uncovert/CipinkoKlingacik/hardware/manufacturing/drill-report.txt

Drill report for cipinkoklingacik.kicad_pcb
Created on 2026-10-30T13:48:10

Copper Layer Stackup:
    =============================================================
    L1 :  F.Cu                      front
    L2 :  B.Cu                      back

Drill file 'cipinkoklingacik-PTH.drl' contains
    plated through holes:
    =============================================================
    T1  0.300mm  0.0118"  (134 holes))
    T2  1.000mm  0.0394"  (59 holes))

    Total plated holes count 193

Drill file 'cipinkoklingacik-NPTH.drl' contains
    unplated through holes:
    =============================================================
    T1  2.700mm  0.1063"  (4 holes))

    Total unplated holes count 4
