uncovert/CipinkoKlingacik/hardware/cipinkoklingacik-pcb-bottom.png

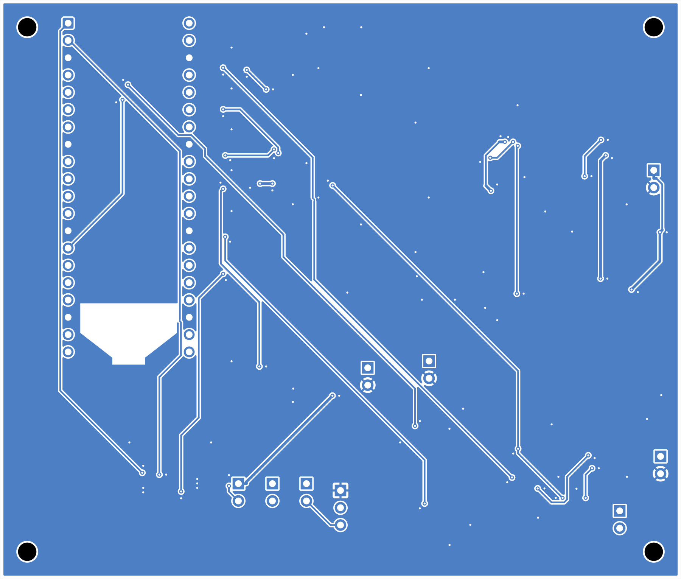
hardware/cipinkoklingacik-pcb-bottom.png
