uncovert/CipinkoKlingacik/hardware/cipinkoklingacik-schematic.png

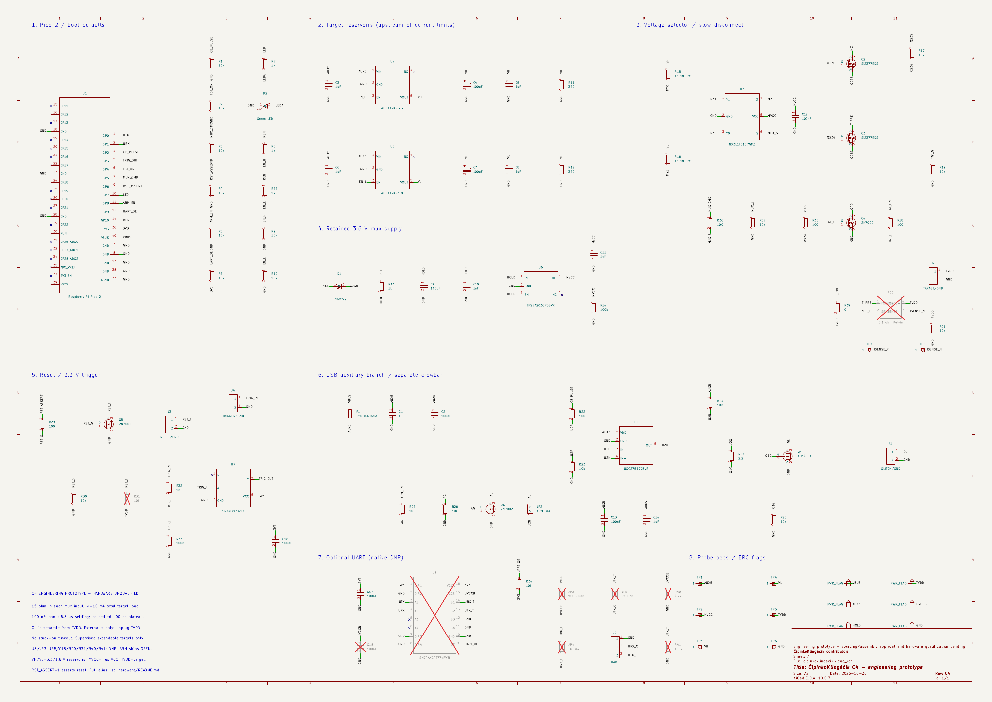
hardware/cipinkoklingacik-schematic.png
