uncovert/CipinkoKlingacik/hardware/visuals/cipinkoklingacik-C4-bottom.png

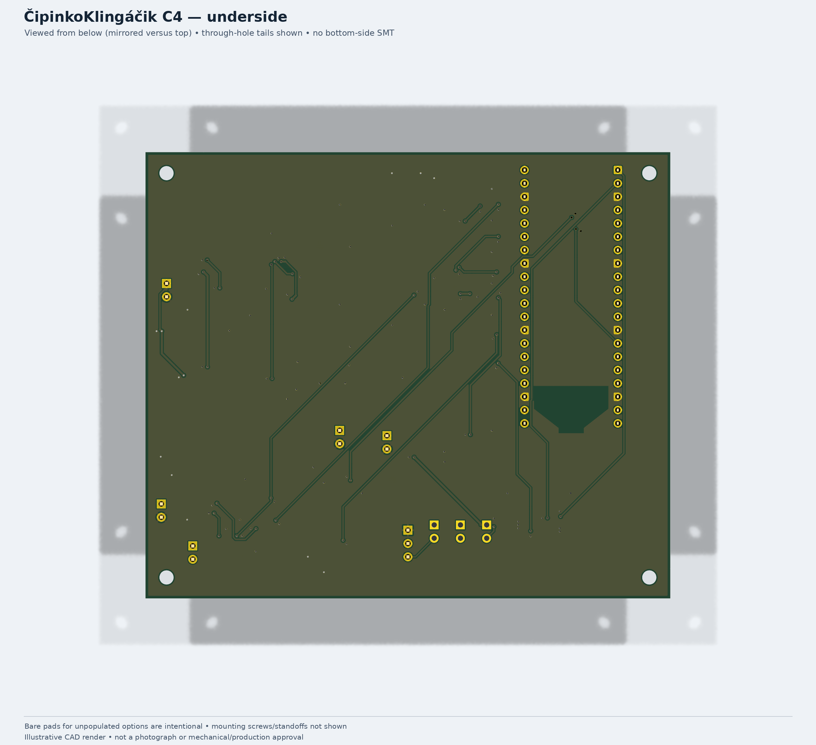
hardware/visuals/cipinkoklingacik-C4-bottom.png
