uncovert/CipinkoKlingacik/hardware/visuals/cipinkoklingacik-C4-module-removed.png

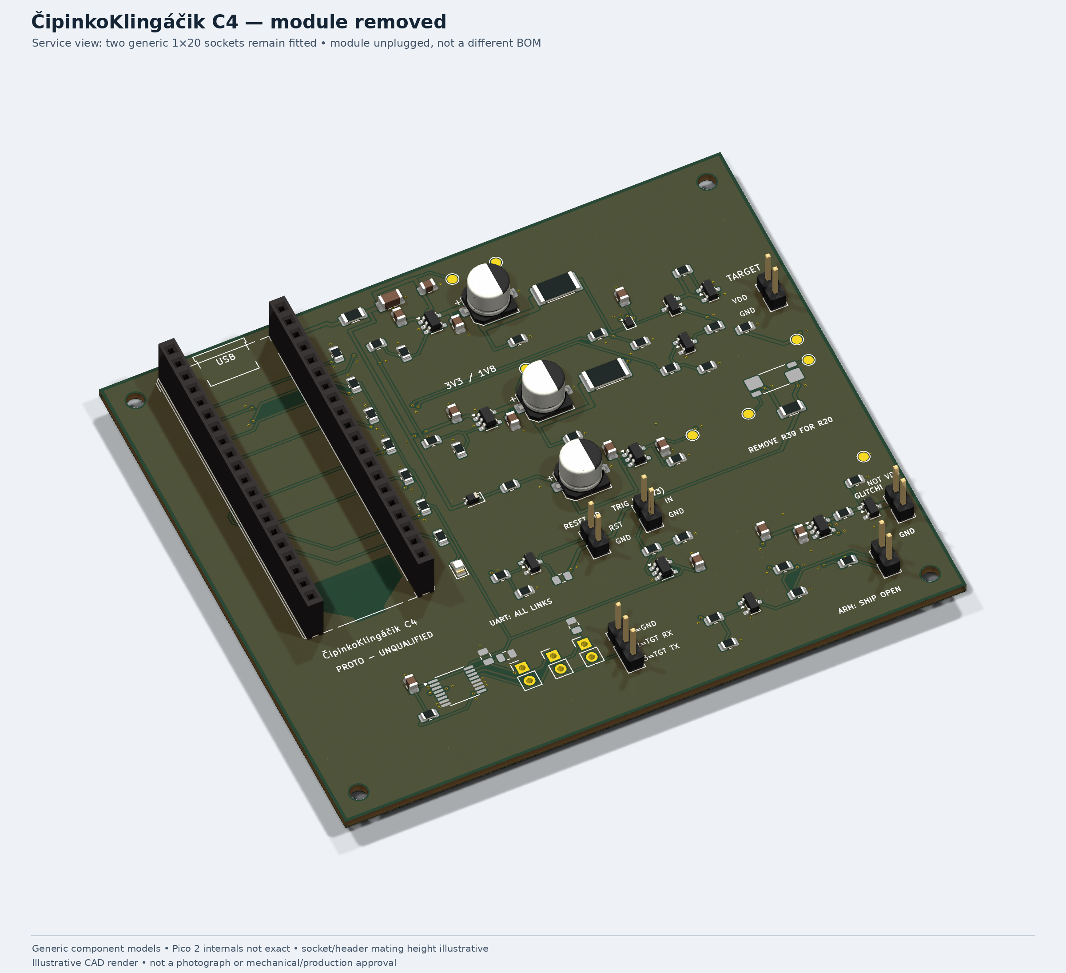
hardware/visuals/cipinkoklingacik-C4-module-removed.png
