uncovert/CipinkoKlingacik/hardware/visuals/cipinkoklingacik-C4-top.png

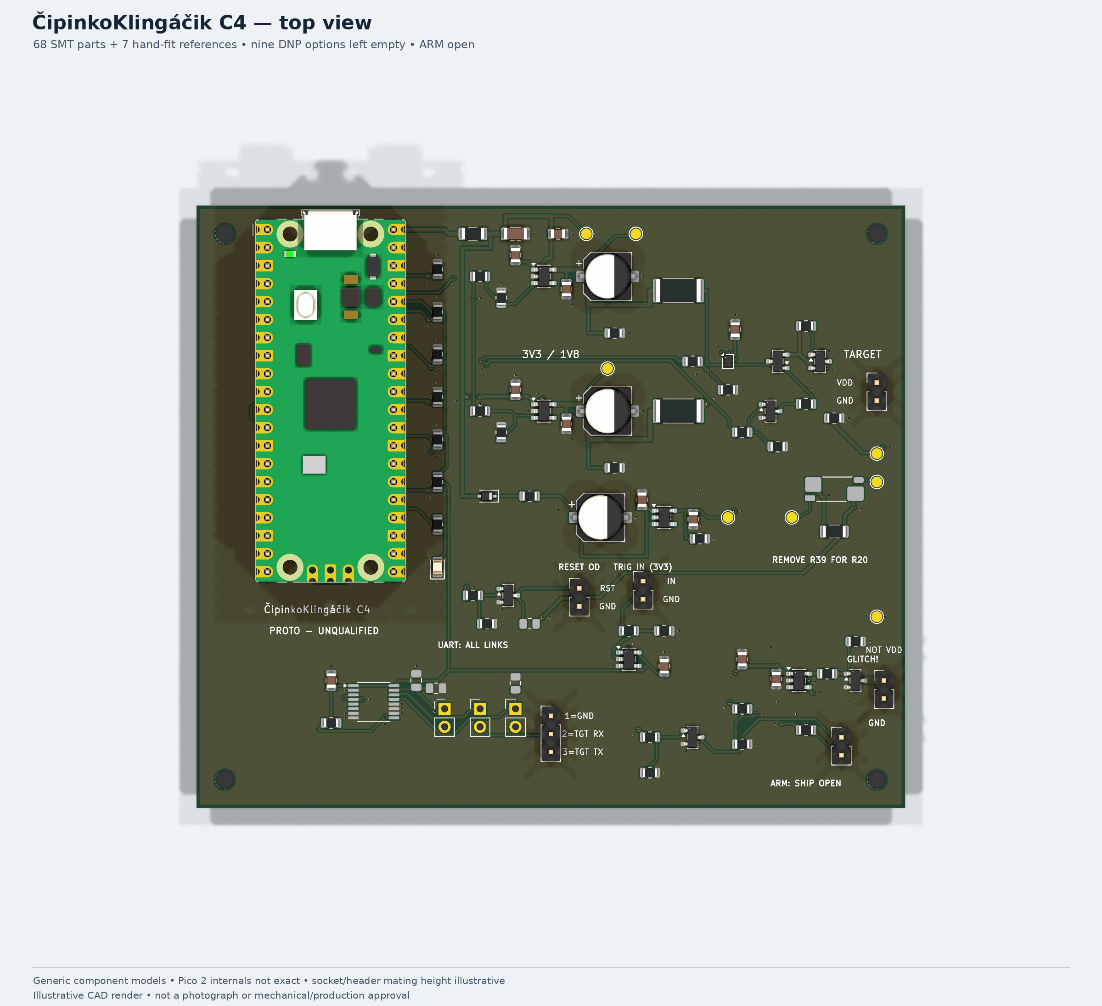
hardware/visuals/cipinkoklingacik-C4-top.png
