uncovert/CipinkoKlingacik/hardware/cipinkoklingacik-bom.csv

Reference | Value | MPN | Manufacturer | Footprint | DNP | Assembly | Requirement | Datasheet | LCSC
U1 | Raspberry Pi Pico 2 | SC1631 | Raspberry Pi | CipinkoKlingacik:RaspberryPi_Pico_Common_THT | no | Module/hand-fit | Pico 2 without headers; hand-fit 2x 1x20 sockets and module headers | https://datasheets.raspberrypi.com/pico/pico-2-datasheet.pdf
R1 | 10k | 0805W8F1002T5E | UNI-ROYAL | CipinkoKlingacik:R_0805_2012Metric | no | SMT | 1%, 0.125 W; gate pulse rating requires check | https://www.lcsc.com/datasheet/lcsc_datasheet_2411221126_UNI-ROYAL-Uniroyal-Elec-0805W8F1002T5E_C17414.pdf | C17414
R2 | 10k | 0805W8F1002T5E | UNI-ROYAL | CipinkoKlingacik:R_0805_2012Metric | no | SMT | 1%, 0.125 W; gate pulse rating requires check | https://www.lcsc.com/datasheet/lcsc_datasheet_2411221126_UNI-ROYAL-Uniroyal-Elec-0805W8F1002T5E_C17414.pdf | C17414
R3 | 10k | 0805W8F1002T5E | UNI-ROYAL | CipinkoKlingacik:R_0805_2012Metric | no | SMT | 1%, 0.125 W; gate pulse rating requires check | https://www.lcsc.com/datasheet/lcsc_datasheet_2411221126_UNI-ROYAL-Uniroyal-Elec-0805W8F1002T5E_C17414.pdf | C17414
R4 | 10k | 0805W8F1002T5E | UNI-ROYAL | CipinkoKlingacik:R_0805_2012Metric | no | SMT | 1%, 0.125 W; gate pulse rating requires check | https://www.lcsc.com/datasheet/lcsc_datasheet_2411221126_UNI-ROYAL-Uniroyal-Elec-0805W8F1002T5E_C17414.pdf | C17414
R5 | 10k | 0805W8F1002T5E | UNI-ROYAL | CipinkoKlingacik:R_0805_2012Metric | no | SMT | 1%, 0.125 W; gate pulse rating requires check | https://www.lcsc.com/datasheet/lcsc_datasheet_2411221126_UNI-ROYAL-Uniroyal-Elec-0805W8F1002T5E_C17414.pdf | C17414
R6 | 10k | 0805W8F1002T5E | UNI-ROYAL | CipinkoKlingacik:R_0805_2012Metric | no | SMT | 1%, 0.125 W; gate pulse rating requires check | https://www.lcsc.com/datasheet/lcsc_datasheet_2411221126_UNI-ROYAL-Uniroyal-Elec-0805W8F1002T5E_C17414.pdf | C17414
R7 | 1k | 0805W8F1001T5E | UNI-ROYAL | CipinkoKlingacik:R_0805_2012Metric | no | SMT | 1%, 0.125 W; gate pulse rating requires check | https://www.lcsc.com/datasheet/lcsc_datasheet_2411221126_UNI-ROYAL-Uniroyal-Elec-0805W8F1002T5E_C17414.pdf | C17513
D2 | Green LED | LTST-C170KGKT | Lite-On | CipinkoKlingacik:LED_0805_2012Metric | no | SMT | Green LED; K1 A2; software status only | https://optoelectronics.liteon.com/upload/download/DS22-2000-223/LTST-C170KGKT.pdf | C98221
R8 | 1k | 0805W8F1001T5E | UNI-ROYAL | CipinkoKlingacik:R_0805_2012Metric | no | SMT | 1%, 0.125 W; gate pulse rating requires check | https://www.lcsc.com/datasheet/lcsc_datasheet_2411221126_UNI-ROYAL-Uniroyal-Elec-0805W8F1002T5E_C17414.pdf | C17513
R9 | 10k | 0805W8F1002T5E | UNI-ROYAL | CipinkoKlingacik:R_0805_2012Metric | no | SMT | 1%, 0.125 W; gate pulse rating requires check | https://www.lcsc.com/datasheet/lcsc_datasheet_2411221126_UNI-ROYAL-Uniroyal-Elec-0805W8F1002T5E_C17414.pdf | C17414
R10 | 10k | 0805W8F1002T5E | UNI-ROYAL | CipinkoKlingacik:R_0805_2012Metric | no | SMT | 1%, 0.125 W; gate pulse rating requires check | https://www.lcsc.com/datasheet/lcsc_datasheet_2411221126_UNI-ROYAL-Uniroyal-Elec-0805W8F1002T5E_C17414.pdf | C17414
R35 | 1k | 0805W8F1001T5E | UNI-ROYAL | CipinkoKlingacik:R_0805_2012Metric | no | SMT | 1%, 0.125 W; gate pulse rating requires check | https://www.lcsc.com/datasheet/lcsc_datasheet_2411221126_UNI-ROYAL-Uniroyal-Elec-0805W8F1002T5E_C17414.pdf | C17513
F1 | 250 mA hold | 1206L025YR | Littelfuse | CipinkoKlingacik:Fuse_1206_3216Metric | no | SMT | 250 mA hold, 500 mA trip, 16 V PTC; 100 A fault rating; R1max 2.3 ohm; 80 ms max trip at 8 A, NOT precision limiting; qualify inrush/drop | https://www.lcsc.com/datasheet/lcsc_datasheet_2304140030_Littelfuse-1206L025YR_C99561.pdf | C99561
C1 | 10uF | GRM31CR71C106KA12L | Murata | CipinkoKlingacik:C_1206_3216Metric | no | SMT | 10 uF, 16 V, X7R, 10%; check DC bias | https://www.murata.com/en-us/products/capacitor/mlcc | C97954
C2 | 100nF | CC0805KRX7R9BB104 | Yageo | CipinkoKlingacik:C_0805_2012Metric | no | SMT | 100 nF, 50 V, X7R, 10% | https://www.lcsc.com/datasheet/lcsc_datasheet_2304140030_YAGEO-CC0805KRX7R9BB104_C49678.pdf | C49678
U2 | UCC27517DBVR | UCC27517DBVR | Texas Instruments | CipinkoKlingacik:SOT-23-5 | no | SMT | 4.90-5.25 V measured at VDD before arm | https://www.ti.com/lit/ds/symlink/ucc27517.pdf | C99395
C13 | 100nF | CC0805KRX7R9BB104 | Yageo | CipinkoKlingacik:C_0805_2012Metric | no | SMT | 100 nF, 50 V, X7R, 10% | https://www.lcsc.com/datasheet/lcsc_datasheet_2304140030_YAGEO-CC0805KRX7R9BB104_C49678.pdf | C49678
C14 | 1uF | GRM21BR71C105KA01L | Murata | CipinkoKlingacik:C_0805_2012Metric | no | SMT | 1 uF, 16 V, X7R, 10%; verify >=0.47 uF at bias | https://www.murata.com/en-us/products/capacitor/mlcc | C77079
R22 | 100 | 0805W8F1000T5E | UNI-ROYAL | CipinkoKlingacik:R_0805_2012Metric | no | SMT | 1%, 0.125 W; gate pulse rating requires check | https://www.lcsc.com/datasheet/lcsc_datasheet_2411221126_UNI-ROYAL-Uniroyal-Elec-0805W8F1002T5E_C17414.pdf | C17408
R23 | 10k | 0805W8F1002T5E | UNI-ROYAL | CipinkoKlingacik:R_0805_2012Metric | no | SMT | 1%, 0.125 W; gate pulse rating requires check | https://www.lcsc.com/datasheet/lcsc_datasheet_2411221126_UNI-ROYAL-Uniroyal-Elec-0805W8F1002T5E_C17414.pdf | C17414
R24 | 10k | 0805W8F1002T5E | UNI-ROYAL | CipinkoKlingacik:R_0805_2012Metric | no | SMT | 1%, 0.125 W; gate pulse rating requires check | https://www.lcsc.com/datasheet/lcsc_datasheet_2411221126_UNI-ROYAL-Uniroyal-Elec-0805W8F1002T5E_C17414.pdf | C17414
Q6 | 2N7002 | 2N7002,215 | Nexperia | CipinkoKlingacik:SOT-23 | no | SMT | G1 S2 D3 | https://assets.nexperia.com/documents/data-sheet/2N7002.pdf | C65189
R25 | 100 | 0805W8F1000T5E | UNI-ROYAL | CipinkoKlingacik:R_0805_2012Metric | no | SMT | 1%, 0.125 W; gate pulse rating requires check | https://www.lcsc.com/datasheet/lcsc_datasheet_2411221126_UNI-ROYAL-Uniroyal-Elec-0805W8F1002T5E_C17414.pdf | C17408
R26 | 10k | 0805W8F1002T5E | UNI-ROYAL | CipinkoKlingacik:R_0805_2012Metric | no | SMT | 1%, 0.125 W; gate pulse rating requires check | https://www.lcsc.com/datasheet/lcsc_datasheet_2411221126_UNI-ROYAL-Uniroyal-Elec-0805W8F1002T5E_C17414.pdf | C17414
JP2 | ARM link | TSW-102-07-G-S | Samtec | CipinkoKlingacik:PinHeader_1x02_P2.54mm_Vertical | no | THT/hand-fit | 2.54 mm header; pin1 marked; hand-fit; removable shunts separate | https://suddendocs.samtec.com/catalog_english/tsw.pdf
Q1 | AO3400A | AO3400A | Alpha & Omega Semiconductor | CipinkoKlingacik:SOT-23 | no | SMT | G1 S2 D3; pulse/thermal qualification required | https://aosmd.com/sites/default/files/res/datasheets/AO3400A.pdf | C20917
R27 | 2.2 | 0805W8F220KT5E | UNI-ROYAL | CipinkoKlingacik:R_0805_2012Metric | no | SMT | 1%, 0.125 W; gate pulse rating requires check | https://www.lcsc.com/datasheet/lcsc_datasheet_2411221126_UNI-ROYAL-Uniroyal-Elec-0805W8F1002T5E_C17414.pdf | C17521
R28 | 10k | 0805W8F1002T5E | UNI-ROYAL | CipinkoKlingacik:R_0805_2012Metric | no | SMT | 1%, 0.125 W; gate pulse rating requires check | https://www.lcsc.com/datasheet/lcsc_datasheet_2411221126_UNI-ROYAL-Uniroyal-Elec-0805W8F1002T5E_C17414.pdf | C17414
J1 | GLITCH/GND | TSW-102-07-G-S | Samtec | CipinkoKlingacik:PinHeader_1x02_P2.54mm_Vertical | no | THT/hand-fit | 2.54 mm header; pin1 marked; hand-fit; removable shunts separate | https://suddendocs.samtec.com/catalog_english/tsw.pdf
D1 | Schottky | BAT54WS-7-F | Diodes Incorporated | CipinkoKlingacik:D_SOD-323 | no | SMT | K1 A2; low-current hold-up charging diode | https://www.diodes.com/assets/Datasheets/BAT54WS.pdf | C124205
R13 | 1k | 0805W8F1001T5E | UNI-ROYAL | CipinkoKlingacik:R_0805_2012Metric | no | SMT | 1%, 0.125 W; gate pulse rating requires check | https://www.lcsc.com/datasheet/lcsc_datasheet_2411221126_UNI-ROYAL-Uniroyal-Elec-0805W8F1002T5E_C17414.pdf | C17513
C9 | 100uF | EEE-FK1C101P | Panasonic | CipinkoKlingacik:CP_Elec_6.3x5.8 | no | SMT | 100 uF 16 V +/-20%, positive pad1; leakage max16 uA; reservoir/hold-up qualification | https://industrial.panasonic.com/cdbs/www-data/pdf/RDE0000/ABA0000C1181.pdf | C128532
C10 | 1uF | GRM21BR71C105KA01L | Murata | CipinkoKlingacik:C_0805_2012Metric | no | SMT | 1 uF, 16 V, X7R, 10%; verify >=0.47 uF at bias | https://www.murata.com/en-us/products/capacitor/mlcc | C77079
U6 | TPS7A2036PDBVR | TPS7A2036PDBVR | Texas Instruments | CipinkoKlingacik:SOT-23-5 | no | SMT | 3.6 V; IN1 GND2 EN3 NC4 OUT5; EN tied to HOLD_IN, not Pico/AUX5; >=0.47 uF effective output; qualify retention/shutdown | https://www.ti.com/lit/ds/symlink/tps7a20.pdf | C2873626
C11 | 1uF | GRM21BR71C105KA01L | Murata | CipinkoKlingacik:C_0805_2012Metric | no | SMT | 1 uF, 16 V, X7R, 10%; verify >=0.47 uF at bias | https://www.murata.com/en-us/products/capacitor/mlcc | C77079
R14 | 100k | 0805W8F1003T5E | UNI-ROYAL | CipinkoKlingacik:R_0805_2012Metric | no | SMT | 1%, 0.125 W; gate pulse rating requires check | https://www.lcsc.com/datasheet/lcsc_datasheet_2411221126_UNI-ROYAL-Uniroyal-Elec-0805W8F1002T5E_C17414.pdf | C149504
U4 | AP2112K-3.3 | AP2112K-3.3TRG1 | Diodes Incorporated | CipinkoKlingacik:SOT-23-5 | no | SMT | 3.3 V; verify reservoir startup and stability | https://www.diodes.com/assets/Datasheets/AP2112.pdf | C51118
C3 | 1uF | GRM21BR71C105KA01L | Murata | CipinkoKlingacik:C_0805_2012Metric | no | SMT | 1 uF, 16 V, X7R, 10%; verify >=0.47 uF at bias | https://www.murata.com/en-us/products/capacitor/mlcc | C77079
C4 | 100uF | EEE-FK1C101P | Panasonic | CipinkoKlingacik:CP_Elec_6.3x5.8 | no | SMT | 100 uF 16 V +/-20%, positive pad1; leakage max16 uA; reservoir/hold-up qualification | https://industrial.panasonic.com/cdbs/www-data/pdf/RDE0000/ABA0000C1181.pdf | C128532
C5 | 1uF | GRM21BR71C105KA01L | Murata | CipinkoKlingacik:C_0805_2012Metric | no | SMT | 1 uF, 16 V, X7R, 10%; verify >=0.47 uF at bias | https://www.murata.com/en-us/products/capacitor/mlcc | C77079
R11 | 330 | 0805W8F3300T5E | UNI-ROYAL | CipinkoKlingacik:R_0805_2012Metric | no | SMT | 1%, 0.125 W; gate pulse rating requires check | https://www.lcsc.com/datasheet/lcsc_datasheet_2411221126_UNI-ROYAL-Uniroyal-Elec-0805W8F1002T5E_C17414.pdf | C17630
U5 | AP2112K-1.8 | AP2112K-1.8TRG1 | Diodes Incorporated | CipinkoKlingacik:SOT-23-5 | no | SMT | 1.8 V; source-only, reservoir/bleeder absorb dip charge | https://www.diodes.com/assets/Datasheets/AP2112.pdf | C176944
C6 | 1uF | GRM21BR71C105KA01L | Murata | CipinkoKlingacik:C_0805_2012Metric | no | SMT | 1 uF, 16 V, X7R, 10%; verify >=0.47 uF at bias | https://www.murata.com/en-us/products/capacitor/mlcc | C77079
C7 | 100uF | EEE-FK1C101P | Panasonic | CipinkoKlingacik:CP_Elec_6.3x5.8 | no | SMT | 100 uF 16 V +/-20%, positive pad1; leakage max16 uA; reservoir/hold-up qualification | https://industrial.panasonic.com/cdbs/www-data/pdf/RDE0000/ABA0000C1181.pdf | C128532
C8 | 1uF | GRM21BR71C105KA01L | Murata | CipinkoKlingacik:C_0805_2012Metric | no | SMT | 1 uF, 16 V, X7R, 10%; verify >=0.47 uF at bias | https://www.murata.com/en-us/products/capacitor/mlcc | C77079
R12 | 330 | 0805W8F3300T5E | UNI-ROYAL | CipinkoKlingacik:R_0805_2012Metric | no | SMT | 1%, 0.125 W; gate pulse rating requires check | https://www.lcsc.com/datasheet/lcsc_datasheet_2411221126_UNI-ROYAL-Uniroyal-Elec-0805W8F1002T5E_C17414.pdf | C17630
R15 | 15 1% 2W | RC2512FK-7W15RL | Yageo | CipinkoKlingacik:R_2512_6332Metric | no | SMT | 15 ohm 1%, 2 W (7W power code); <=0.756 W bounded peak, no pulse-overload credit; qualify >=1 W on actual PCB and derating | https://wmsc.lcsc.com/wmsc/upload/file/pdf/v2/lcsc/2312191106_YAGEO-RC2512FK-7W15RL_C6639259.pdf | C6639259
R16 | 15 1% 2W | RC2512FK-7W15RL | Yageo | CipinkoKlingacik:R_2512_6332Metric | no | SMT | 15 ohm 1%, 2 W (7W power code); <=0.756 W bounded peak, no pulse-overload credit; qualify >=1 W on actual PCB and derating | https://wmsc.lcsc.com/wmsc/upload/file/pdf/v2/lcsc/2312191106_YAGEO-RC2512FK-7W15RL_C6639259.pdf | C6639259
U3 | NX3L1T3157GMZ | NX3L1T3157GMZ | NXP | CipinkoKlingacik:SOT-886 | no | SMT | XSON6/SOT886; GMZ ordering code, not obsolete ,115/,132 | https://www.nxp.com/docs/en/data-sheet/NX3L1T3157.pdf | C1870392
R36 | 100 | 0805W8F1000T5E | UNI-ROYAL | CipinkoKlingacik:R_0805_2012Metric | no | SMT | 1%, 0.125 W; gate pulse rating requires check | https://www.lcsc.com/datasheet/lcsc_datasheet_2411221126_UNI-ROYAL-Uniroyal-Elec-0805W8F1002T5E_C17414.pdf | C17408
R37 | 10k | 0805W8F1002T5E | UNI-ROYAL | CipinkoKlingacik:R_0805_2012Metric | no | SMT | 1%, 0.125 W; gate pulse rating requires check | https://www.lcsc.com/datasheet/lcsc_datasheet_2411221126_UNI-ROYAL-Uniroyal-Elec-0805W8F1002T5E_C17414.pdf | C17414
C12 | 100nF | CC0805KRX7R9BB104 | Yageo | CipinkoKlingacik:C_0805_2012Metric | no | SMT | 100 nF, 50 V, X7R, 10% | https://www.lcsc.com/datasheet/lcsc_datasheet_2304140030_YAGEO-CC0805KRX7R9BB104_C49678.pdf | C49678
Q2 | Si2377EDS | Si2377EDS-T1-GE3 | Vishay | CipinkoKlingacik:SOT-23 | no | SMT | G1 S2 D3; common-source slow disconnect; -1.5 V drive specified | https://www.vishay.com/docs/65905/si2377eds.pdf | C143698
Q3 | Si2377EDS | Si2377EDS-T1-GE3 | Vishay | CipinkoKlingacik:SOT-23 | no | SMT | G1 S2 D3; common-source slow disconnect; -1.5 V drive specified | https://www.vishay.com/docs/65905/si2377eds.pdf | C143698
R17 | 10k | 0805W8F1002T5E | UNI-ROYAL | CipinkoKlingacik:R_0805_2012Metric | no | SMT | 1%, 0.125 W; gate pulse rating requires check | https://www.lcsc.com/datasheet/lcsc_datasheet_2411221126_UNI-ROYAL-Uniroyal-Elec-0805W8F1002T5E_C17414.pdf | C17414
Q4 | 2N7002 | 2N7002,215 | Nexperia | CipinkoKlingacik:SOT-23 | no | SMT | G1 S2 D3 | https://assets.nexperia.com/documents/data-sheet/2N7002.pdf | C65189
R38 | 100 | 0805W8F1000T5E | UNI-ROYAL | CipinkoKlingacik:R_0805_2012Metric | no | SMT | 1%, 0.125 W; gate pulse rating requires check | https://www.lcsc.com/datasheet/lcsc_datasheet_2411221126_UNI-ROYAL-Uniroyal-Elec-0805W8F1002T5E_C17414.pdf | C17408
R18 | 100 | 0805W8F1000T5E | UNI-ROYAL | CipinkoKlingacik:R_0805_2012Metric | no | SMT | 1%, 0.125 W; gate pulse rating requires check | https://www.lcsc.com/datasheet/lcsc_datasheet_2411221126_UNI-ROYAL-Uniroyal-Elec-0805W8F1002T5E_C17414.pdf | C17408
R19 | 10k | 0805W8F1002T5E | UNI-ROYAL | CipinkoKlingacik:R_0805_2012Metric | no | SMT | 1%, 0.125 W; gate pulse rating requires check | https://www.lcsc.com/datasheet/lcsc_datasheet_2411221126_UNI-ROYAL-Uniroyal-Elec-0805W8F1002T5E_C17414.pdf | C17414
R39 | 0 | 1206W4F0000T5E | UNI-ROYAL | CipinkoKlingacik:R_1206_3216Metric | no | SMT | Fitted zero-ohm bypass; REMOVE when R20 fitted; not a removable ARM link | https://www.lcsc.com/datasheet/lcsc_datasheet_2206010200_UNI-ROYAL-Uniroyal-Elec-1206W4F0000T5E_C17888.pdf | C17888
J2 | TARGET/GND | TSW-102-07-G-S | Samtec | CipinkoKlingacik:PinHeader_1x02_P2.54mm_Vertical | no | THT/hand-fit | 2.54 mm header; pin1 marked; hand-fit; removable shunts separate | https://suddendocs.samtec.com/catalog_english/tsw.pdf
R21 | 10k | 0805W8F1002T5E | UNI-ROYAL | CipinkoKlingacik:R_0805_2012Metric | no | SMT | 1%, 0.125 W; gate pulse rating requires check | https://www.lcsc.com/datasheet/lcsc_datasheet_2411221126_UNI-ROYAL-Uniroyal-Elec-0805W8F1002T5E_C17414.pdf | C17414
Q5 | 2N7002 | 2N7002,215 | Nexperia | CipinkoKlingacik:SOT-23 | no | SMT | G1 S2 D3 | https://assets.nexperia.com/documents/data-sheet/2N7002.pdf | C65189
R29 | 100 | 0805W8F1000T5E | UNI-ROYAL | CipinkoKlingacik:R_0805_2012Metric | no | SMT | 1%, 0.125 W; gate pulse rating requires check | https://www.lcsc.com/datasheet/lcsc_datasheet_2411221126_UNI-ROYAL-Uniroyal-Elec-0805W8F1002T5E_C17414.pdf | C17408
R30 | 10k | 0805W8F1002T5E | UNI-ROYAL | CipinkoKlingacik:R_0805_2012Metric | no | SMT | 1%, 0.125 W; gate pulse rating requires check | https://www.lcsc.com/datasheet/lcsc_datasheet_2411221126_UNI-ROYAL-Uniroyal-Elec-0805W8F1002T5E_C17414.pdf | C17414
J3 | RESET/GND | TSW-102-07-G-S | Samtec | CipinkoKlingacik:PinHeader_1x02_P2.54mm_Vertical | no | THT/hand-fit | 2.54 mm header; pin1 marked; hand-fit; removable shunts separate | https://suddendocs.samtec.com/catalog_english/tsw.pdf
U7 | SN74LVC1G17 | SN74LVC1G17DBVR | Texas Instruments | CipinkoKlingacik:SOT-23-5 | no | SMT | 3.3 V trigger input only | https://www.ti.com/lit/ds/symlink/sn74lvc1g17.pdf | C7836
C16 | 100nF | CC0805KRX7R9BB104 | Yageo | CipinkoKlingacik:C_0805_2012Metric | no | SMT | 100 nF, 50 V, X7R, 10% | https://www.lcsc.com/datasheet/lcsc_datasheet_2304140030_YAGEO-CC0805KRX7R9BB104_C49678.pdf | C49678
R32 | 1k | 0805W8F1001T5E | UNI-ROYAL | CipinkoKlingacik:R_0805_2012Metric | no | SMT | 1%, 0.125 W; gate pulse rating requires check | https://www.lcsc.com/datasheet/lcsc_datasheet_2411221126_UNI-ROYAL-Uniroyal-Elec-0805W8F1002T5E_C17414.pdf | C17513
R33 | 100k | 0805W8F1003T5E | UNI-ROYAL | CipinkoKlingacik:R_0805_2012Metric | no | SMT | 1%, 0.125 W; gate pulse rating requires check | https://www.lcsc.com/datasheet/lcsc_datasheet_2411221126_UNI-ROYAL-Uniroyal-Elec-0805W8F1002T5E_C17414.pdf | C149504
J4 | TRIGGER/GND | TSW-102-07-G-S | Samtec | CipinkoKlingacik:PinHeader_1x02_P2.54mm_Vertical | no | THT/hand-fit | 2.54 mm header; pin1 marked; hand-fit; removable shunts separate | https://suddendocs.samtec.com/catalog_english/tsw.pdf
C17 | 100nF | CC0805KRX7R9BB104 | Yageo | CipinkoKlingacik:C_0805_2012Metric | no | SMT | 100 nF, 50 V, X7R, 10% | https://www.lcsc.com/datasheet/lcsc_datasheet_2304140030_YAGEO-CC0805KRX7R9BB104_C49678.pdf | C49678
R34 | 10k | 0805W8F1002T5E | UNI-ROYAL | CipinkoKlingacik:R_0805_2012Metric | no | SMT | 1%, 0.125 W; gate pulse rating requires check | https://www.lcsc.com/datasheet/lcsc_datasheet_2411221126_UNI-ROYAL-Uniroyal-Elec-0805W8F1002T5E_C17414.pdf | C17414
J5 | UART | TSW-103-07-G-S | Samtec | CipinkoKlingacik:PinHeader_1x03_P2.54mm_Vertical | no | THT/hand-fit | 2.54 mm header; pin1 marked; hand-fit; removable shunts separate | https://suddendocs.samtec.com/catalog_english/tsw.pdf
