uncovert/CipinkoKlingacik/hardware/cipinkoklingacik-pcb-review.pdf

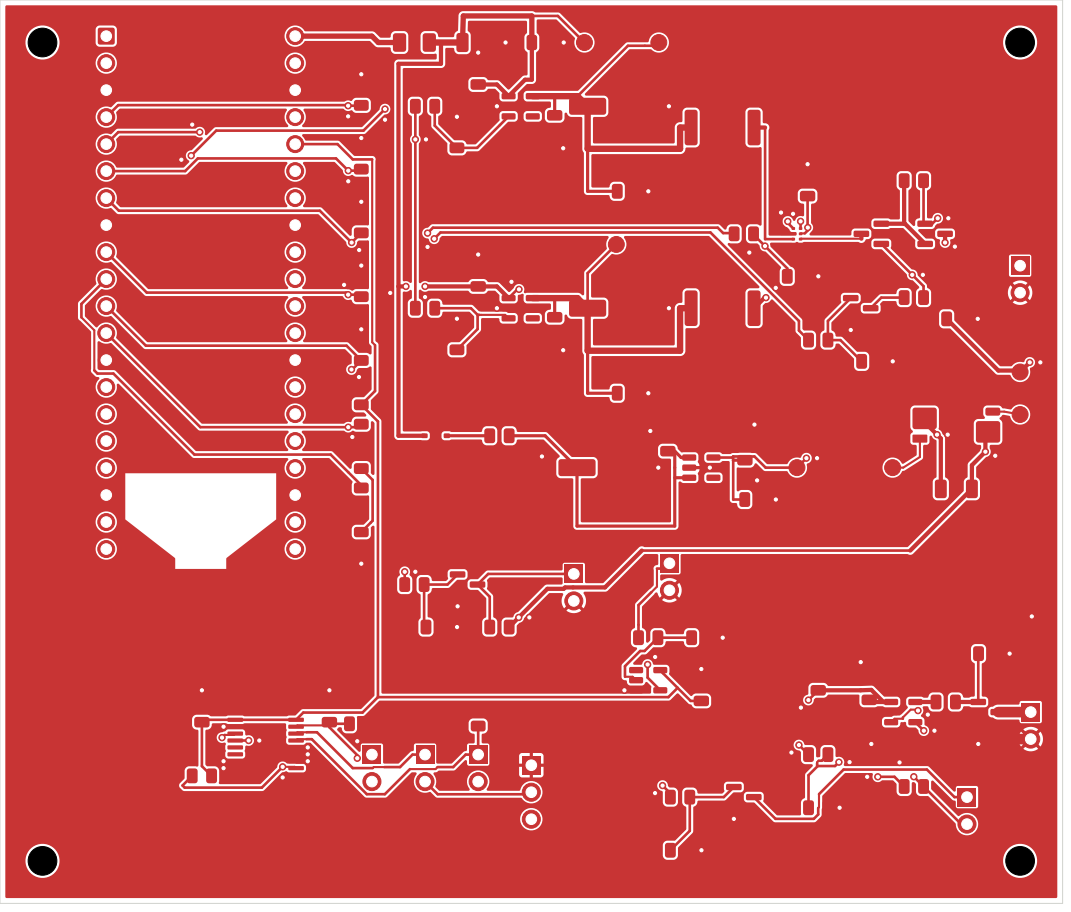
[picture p9: page 1]

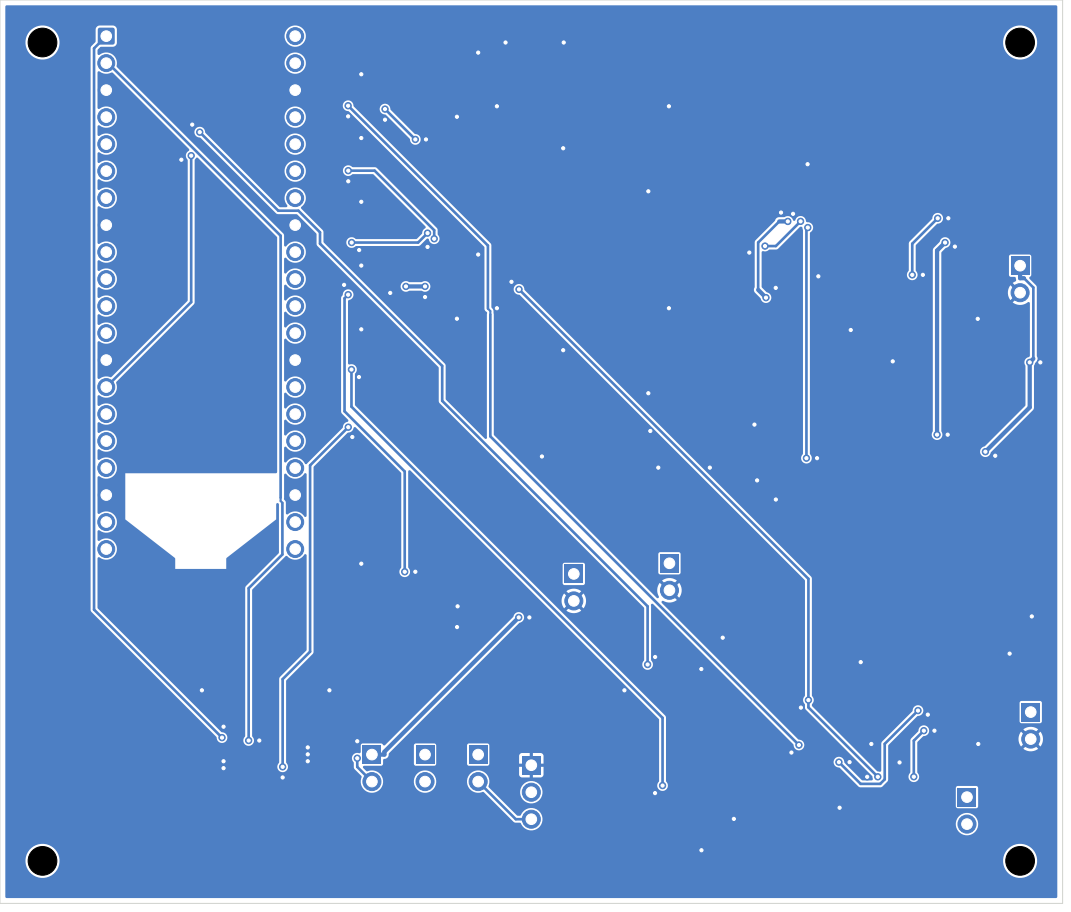
[picture p10: page 2]

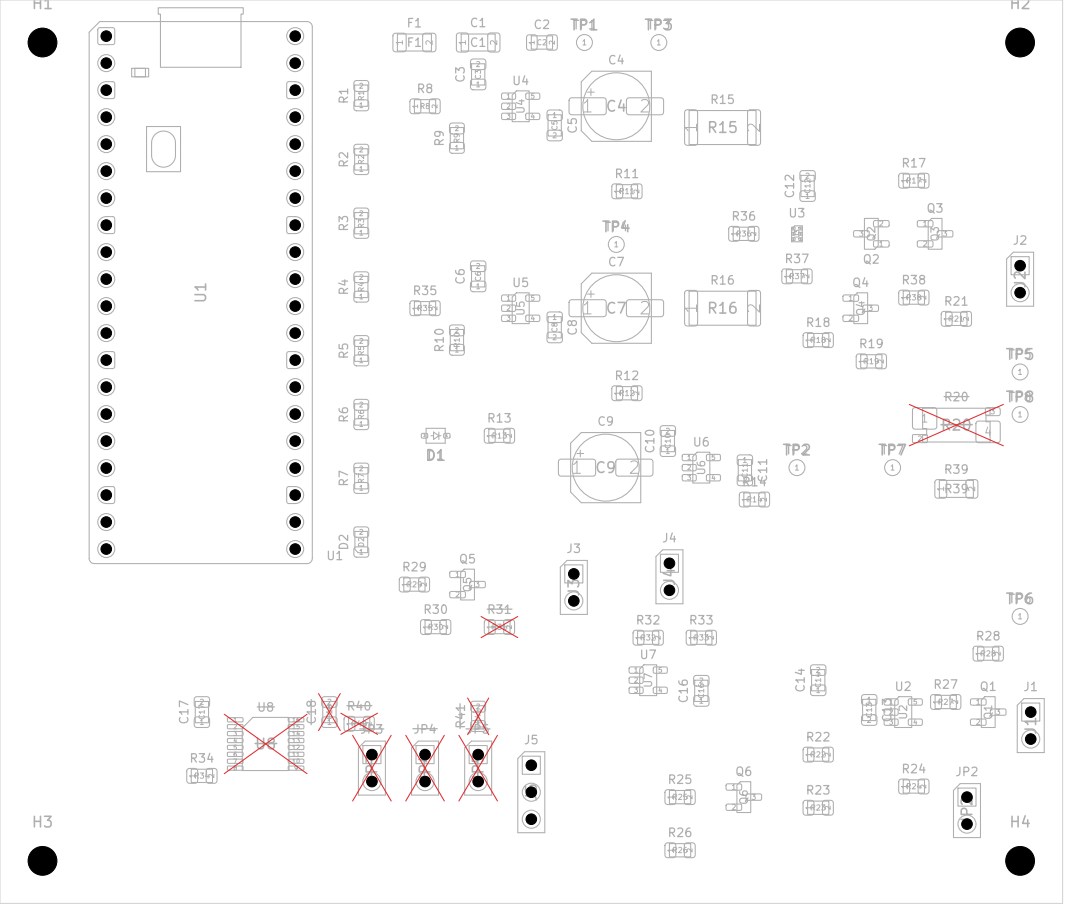
[picture p11: page 3]

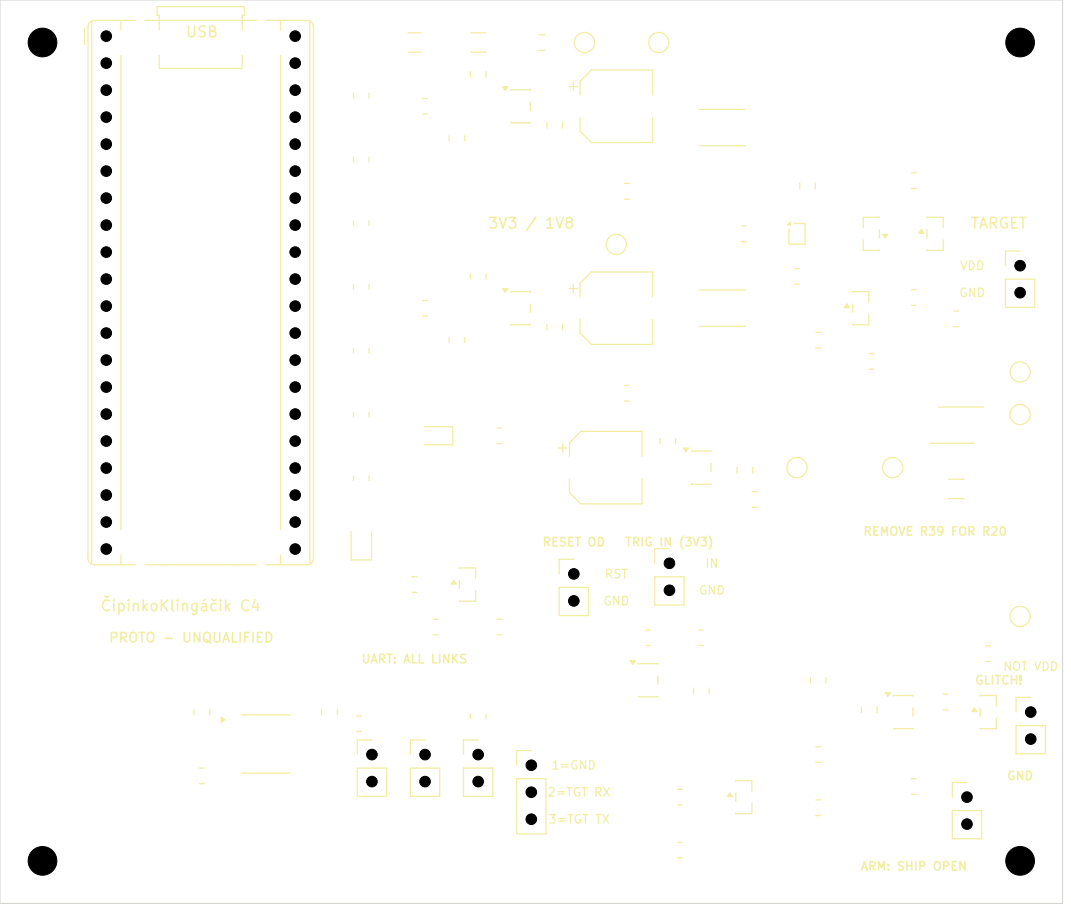
[picture p12: page 4]

REMOVE R39 FOR R20 GLITCH! GND PROTO - UNQUALIFIED ČipinkoKlingáčik C4 USB

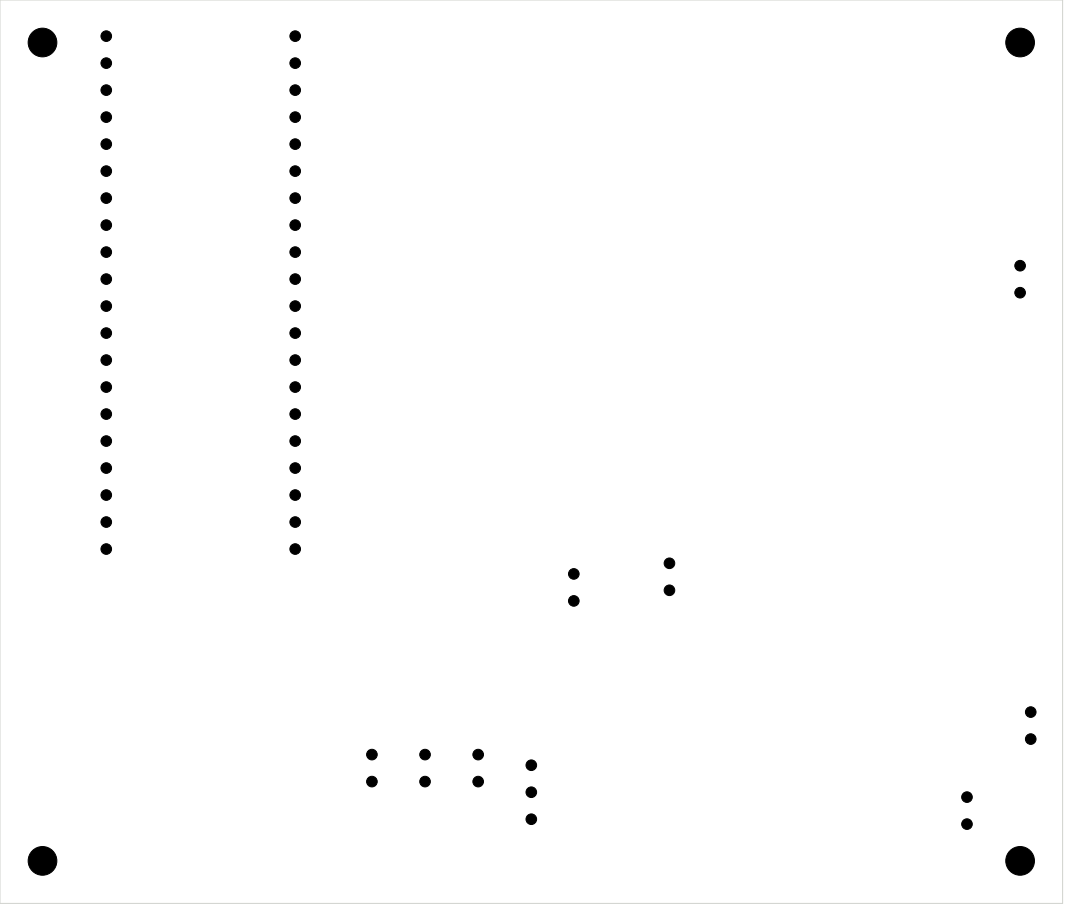
[picture p13: page 5]
