uncovert/CipinkoKlingacik/hardware/cipinkoklingacik.pdf

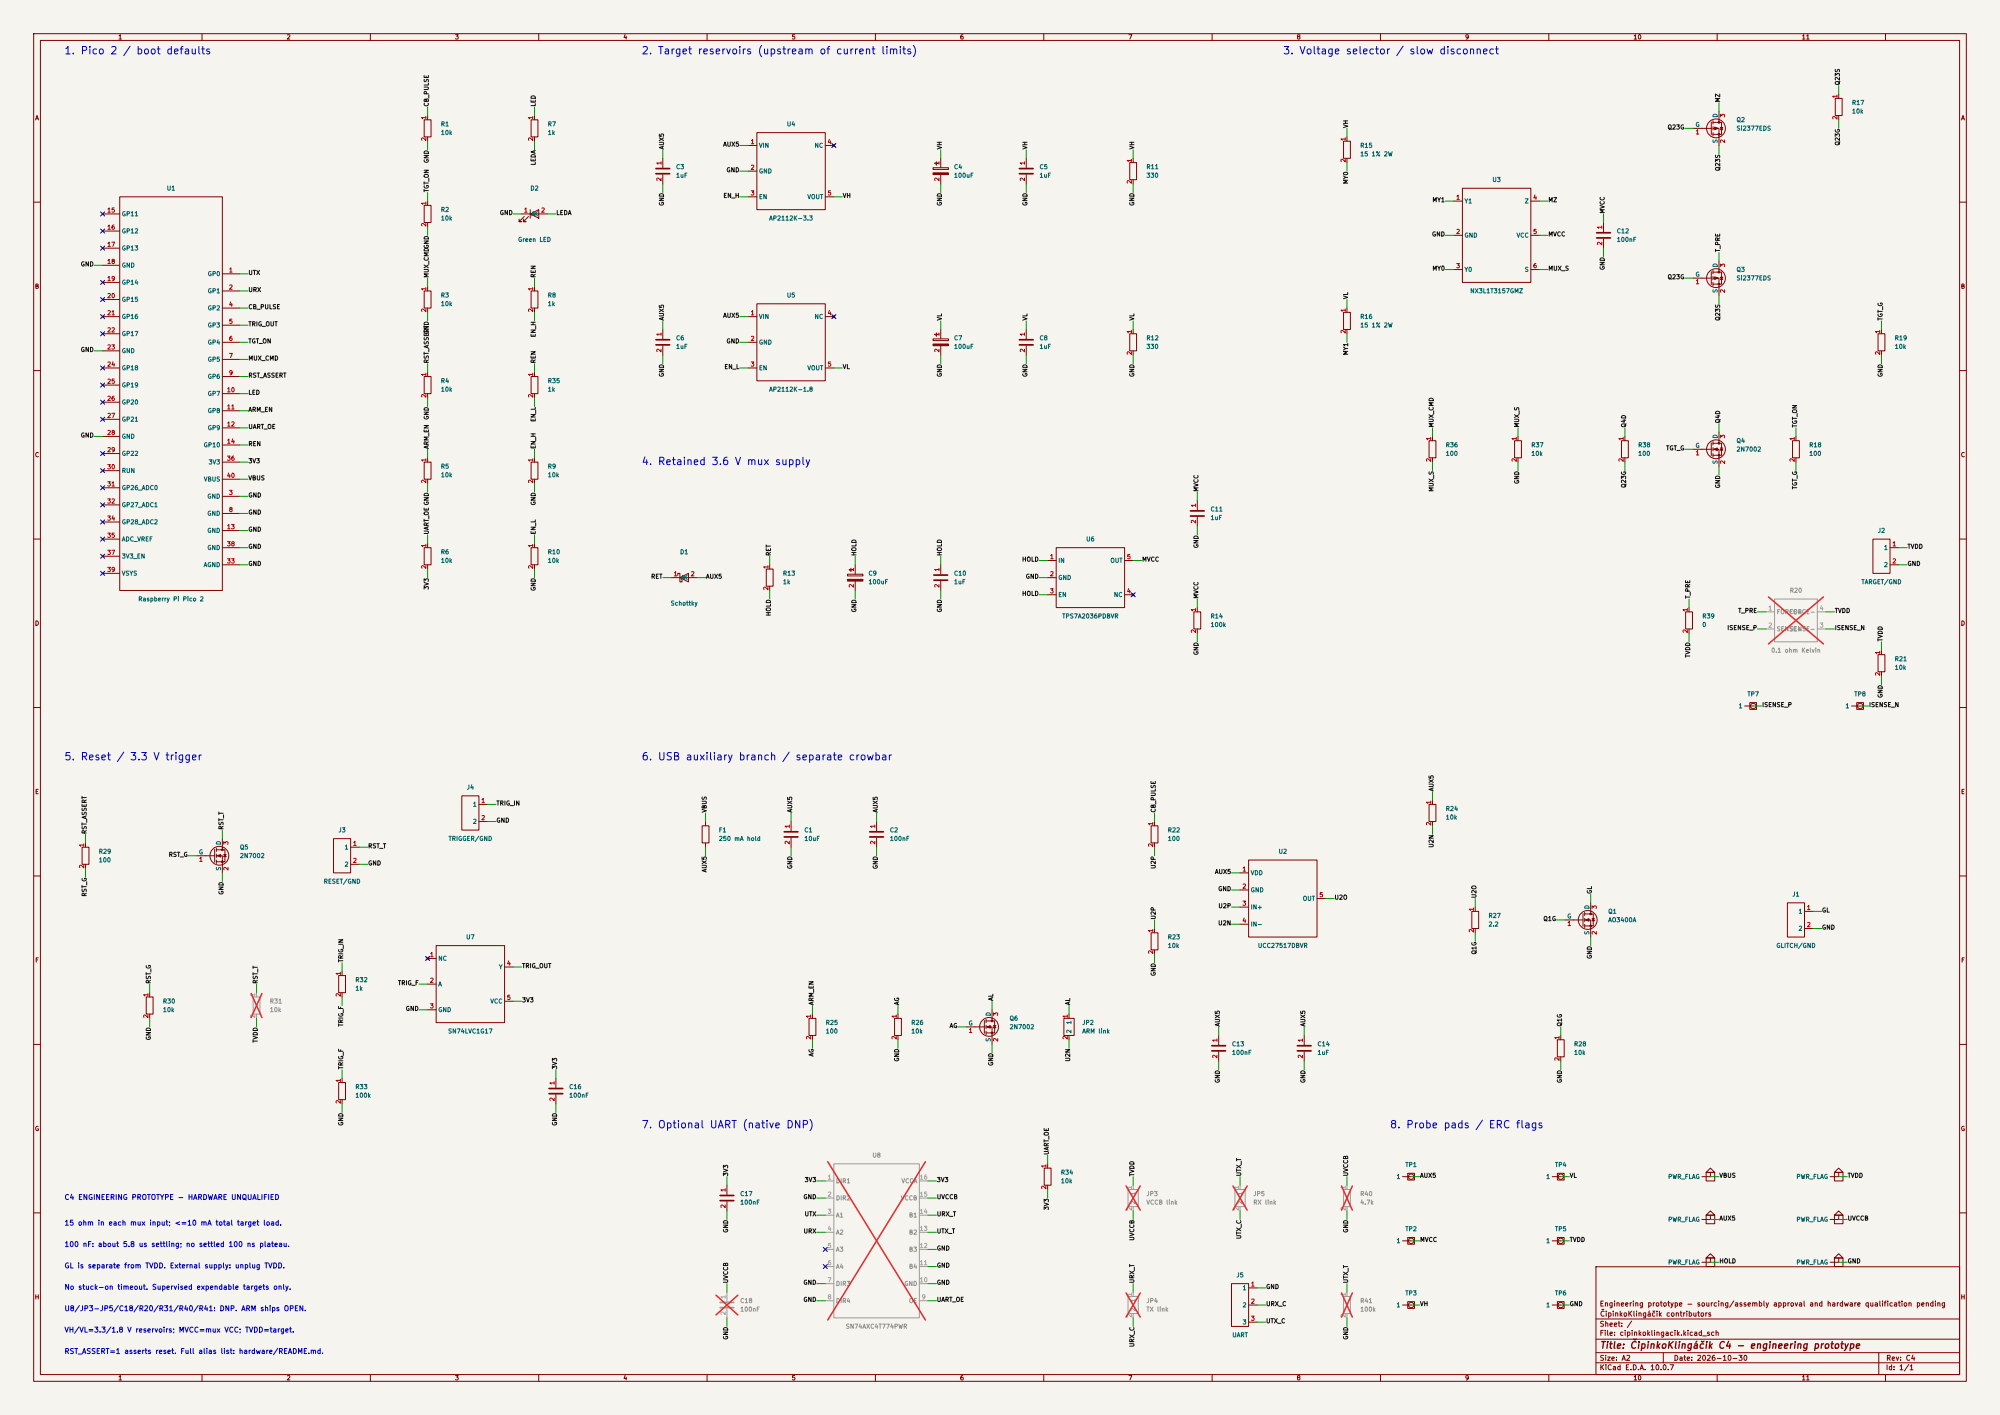
[picture p14: page 1]

2. Target reservoirs (upstream of current limits)

3. Voltage selector / slow disconnect

6. USB auxiliary branch / separate crowbar

7. Optional UART (native DNP)

8. Probe pads / ERC flags

C4 ENGINEERING PROTOTYPE - HARDWARE UNQUALIFIED

15 ohm in each mux input; <=10 mA total target load.

100 nF: about 5.8 us settling; no settled 100 ns plateau.

GL is separate from TVDD. External supply: unplug TVDD.

No stuck-on timeout. Supervised expendable targets only.

U8/JP3-JP5/C18/R20/R31/R40/R41: DNP. ARM ships OPEN.

Engineering prototype - sourcing/assembly approval and hardware qualification pending
ČipinkoKlingáčik contributors
Sheet: /
File: cipinkoklingacik.kicad_sch
Title: ČipinkoKlingáčik C4 - engineering prototype

VH/VL=3.3/1.8 V reservoirs; MVCC=mux VCC; TVDD=target.

RST_ASSERT=1 asserts reset. Full alias list: hardware/README.md.

Size: A2 | Rev: C4
KiCad E.D.A. 10.0.7 | Id: 1/1
