uncovert/CipinkoKlingacik/hardware/cipinkoklingacik.kicad_pcb

## KiCad design hardware/cipinkoklingacik.kicad_pcb (2026-10-30)

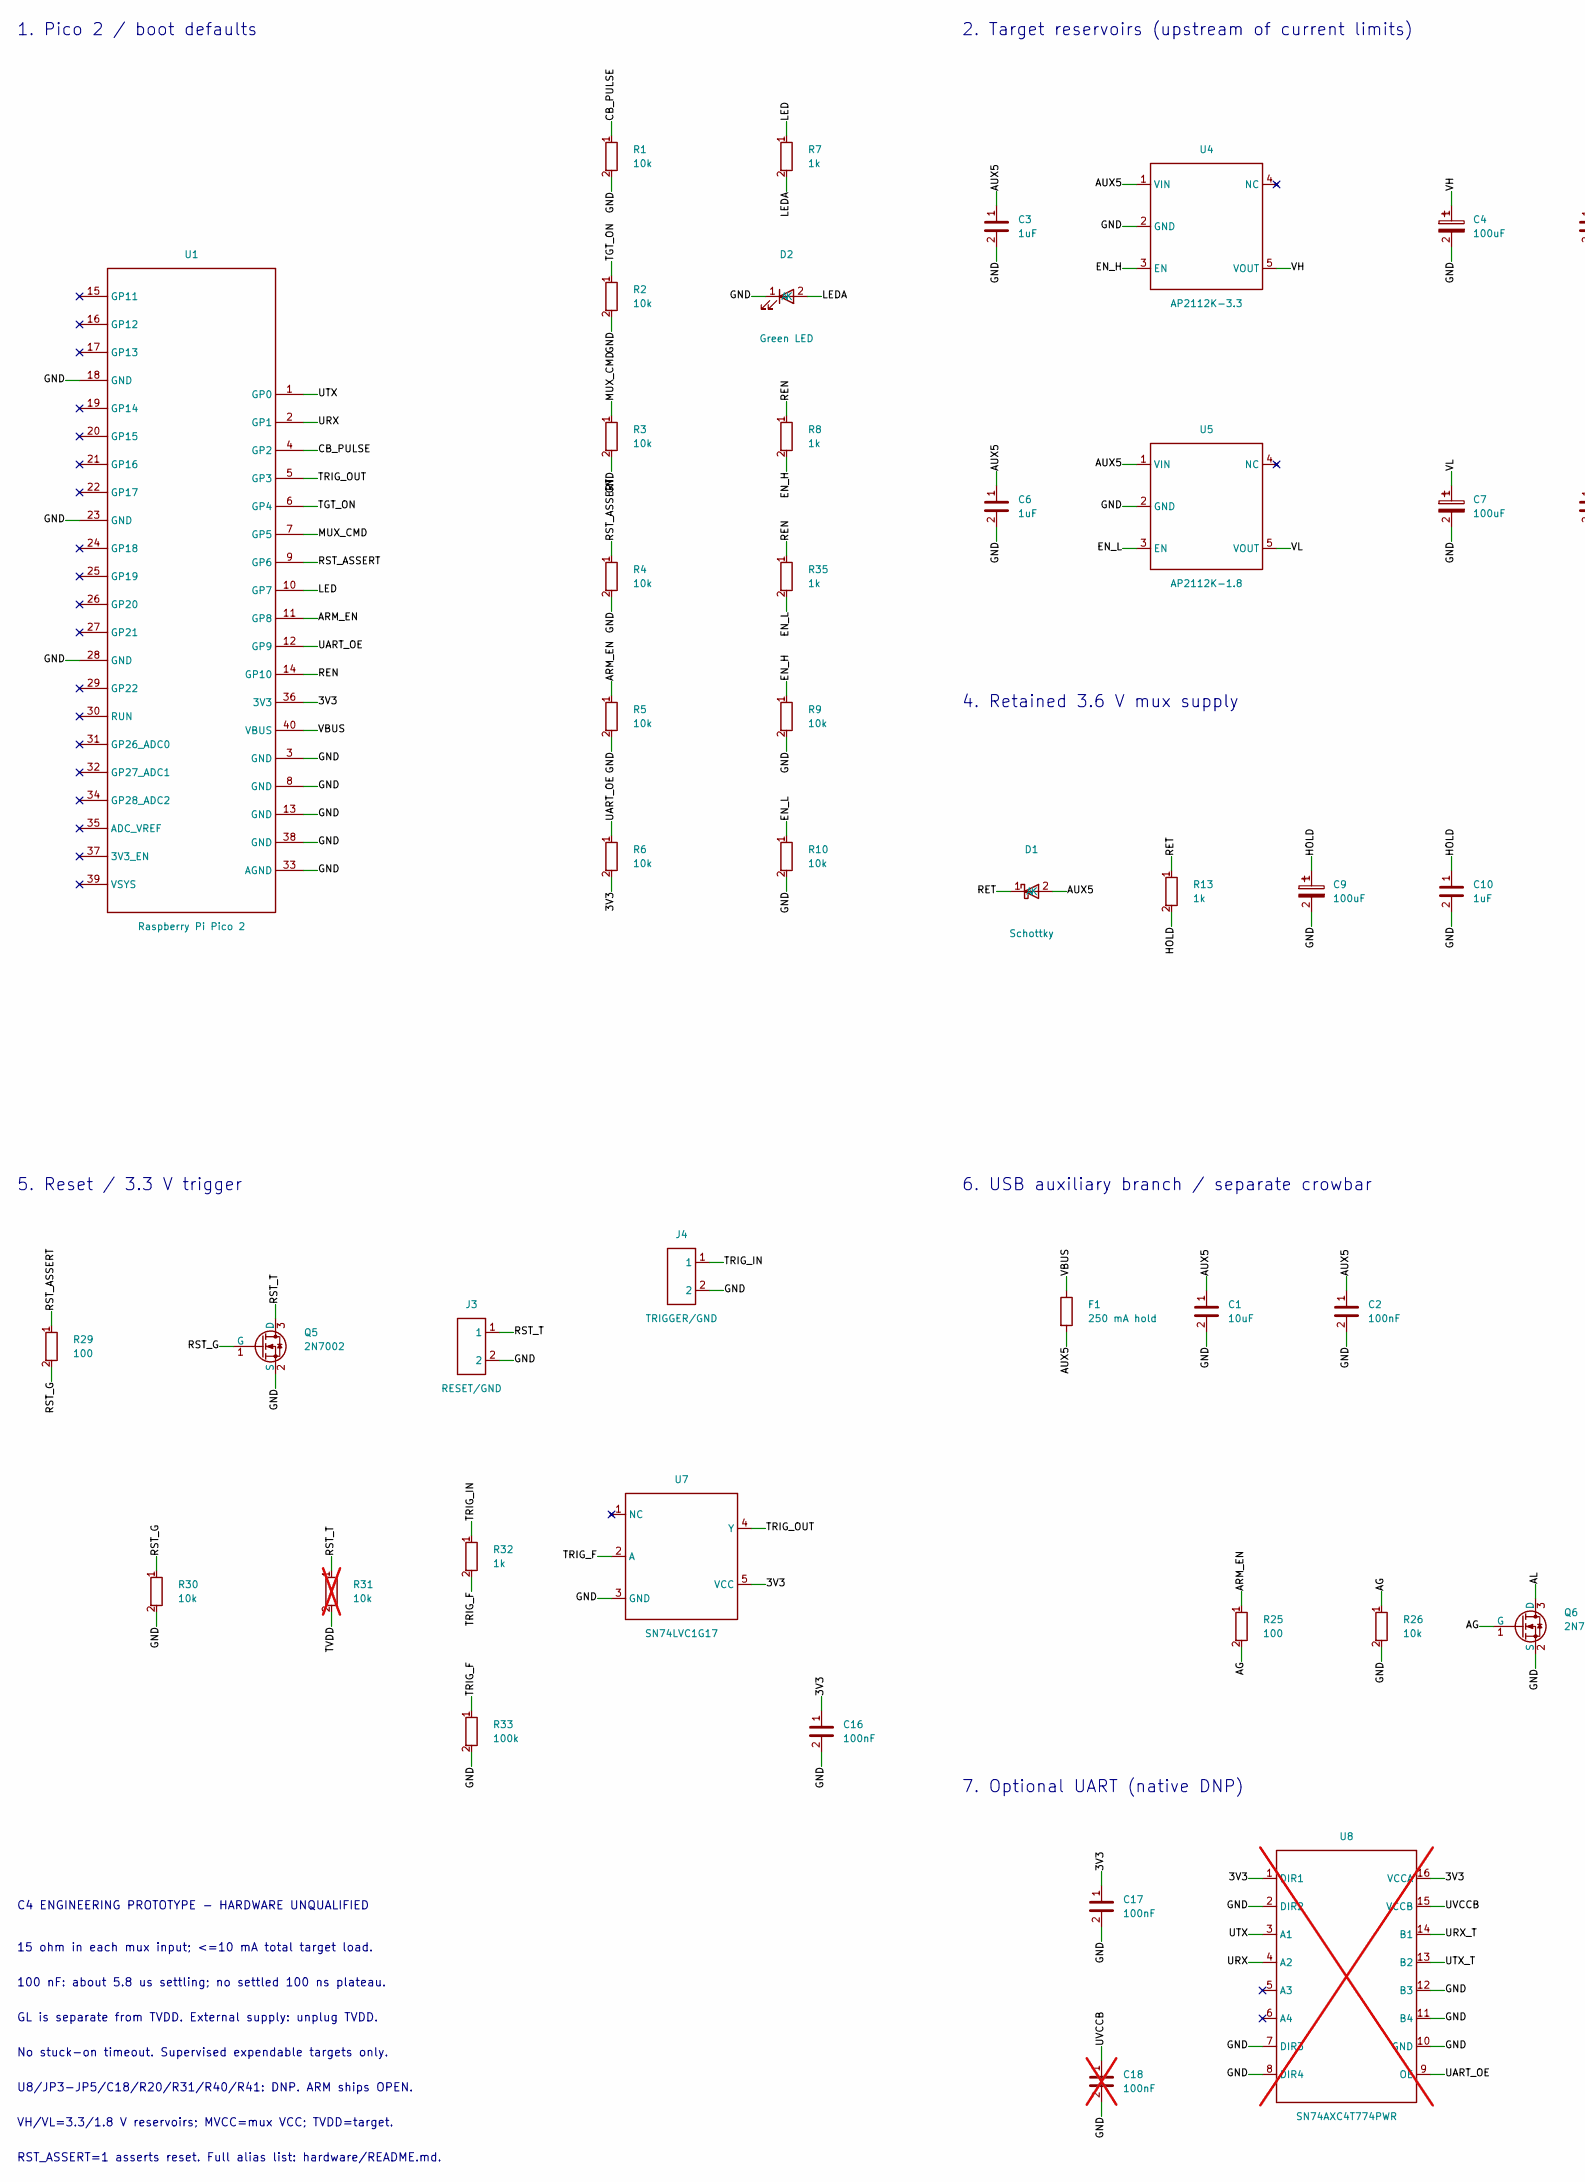
[picture p15: schematic cipinkoklingacik.kicad_sch, ČipinkoKlingáčik C4 - engineering prototype, part in row 1, column 1]

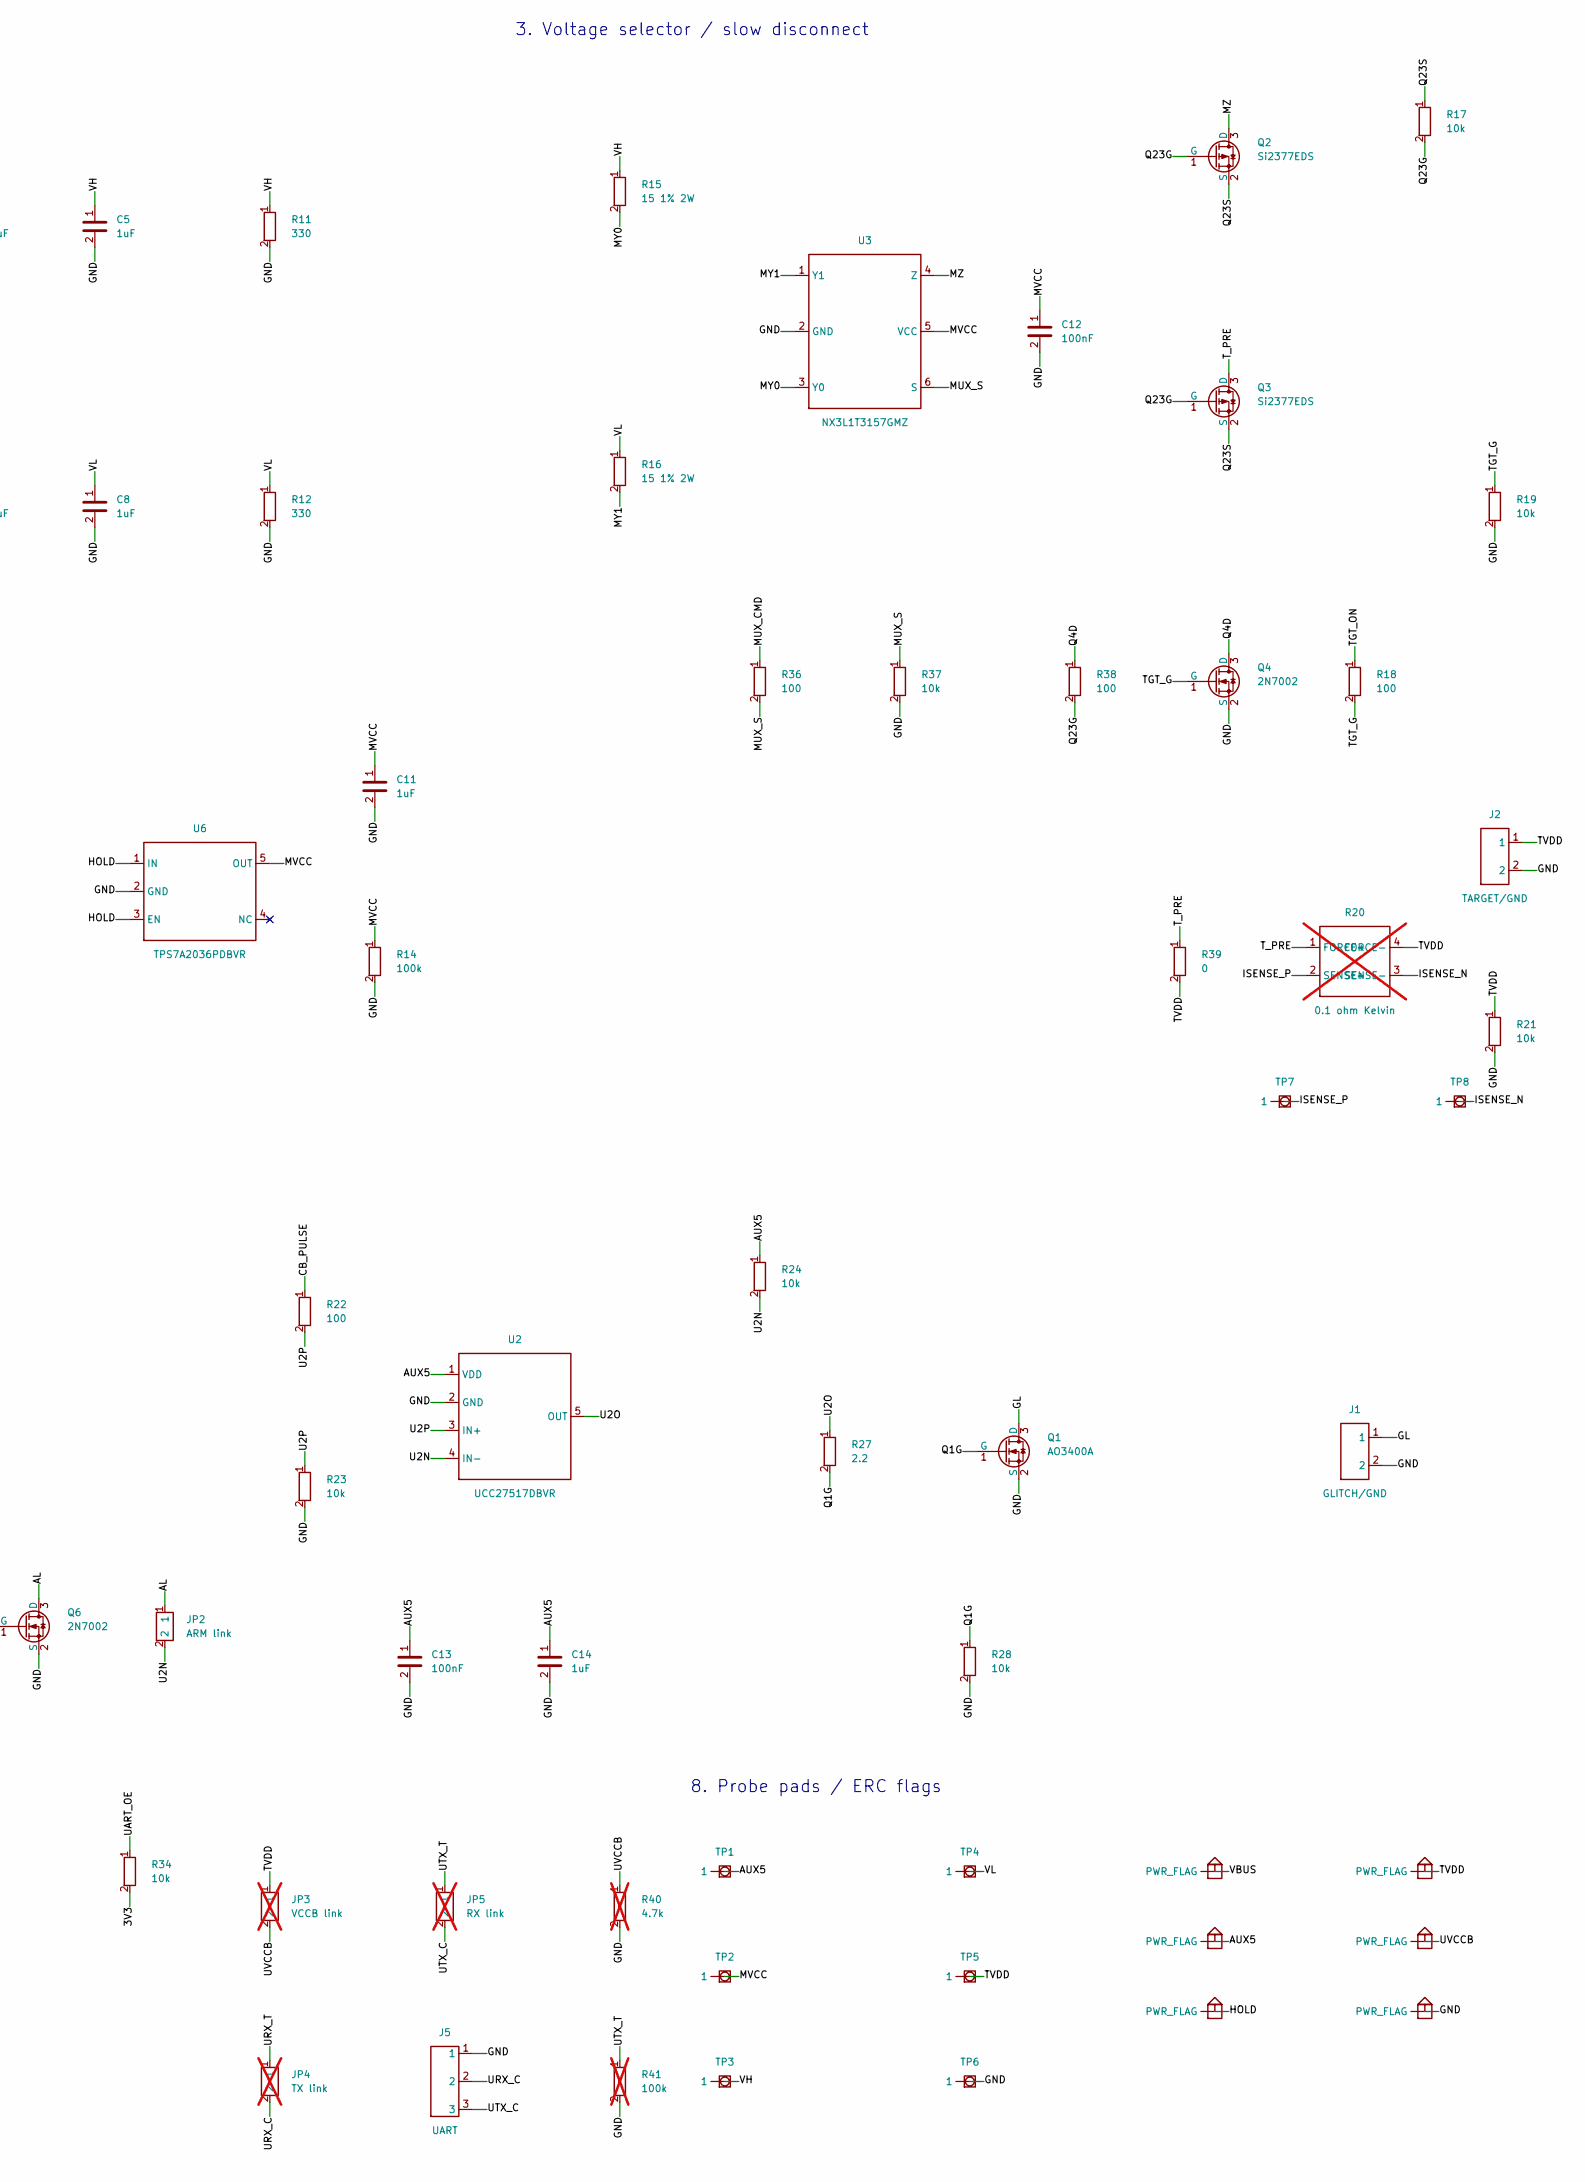
[picture p16: schematic cipinkoklingacik.kicad_sch, ČipinkoKlingáčik C4 - engineering prototype, part in row 1, column 2]

Parts:
C1: 10uF; C_1206_3216Metric; MPN GRM31CR71C106KA12L; LCSC C97954
C2, C12, C13, C16, C17: 100nF; C_0805_2012Metric; MPN CC0805KRX7R9BB104; LCSC C49678
C3, C5, C6, C8, C10, C11, C14: 1uF; C_0805_2012Metric; MPN GRM21BR71C105KA01L; LCSC C77079
C4, C7, C9: 100uF; CP_Elec_6.3x5.8; MPN EEE-FK1C101P; LCSC C128532
C18: 100nF; C_0805_2012Metric; MPN CC0805KRX7R9BB104; LCSC C49678; not fitted
D1: Schottky; D_SOD-323; MPN BAT54WS-7-F; LCSC C124205
D2: Green LED; LED_0805_2012Metric; MPN LTST-C170KGKT; LCSC C98221
F1: 250 mA hold; Fuse_1206_3216Metric; MPN 1206L025YR; LCSC C99561
J1: GLITCH/GND; PinHeader_1x02_P2.54mm_Vertical; MPN TSW-102-07-G-S
J2: TARGET/GND; PinHeader_1x02_P2.54mm_Vertical; MPN TSW-102-07-G-S
J3: RESET/GND; PinHeader_1x02_P2.54mm_Vertical; MPN TSW-102-07-G-S
J4: TRIGGER/GND; PinHeader_1x02_P2.54mm_Vertical; MPN TSW-102-07-G-S
J5: UART; PinHeader_1x03_P2.54mm_Vertical; MPN TSW-103-07-G-S
JP2: ARM link; PinHeader_1x02_P2.54mm_Vertical; MPN TSW-102-07-G-S
JP3: VCCB link; PinHeader_1x02_P2.54mm_Vertical; MPN TSW-102-07-G-S; not fitted
JP4: TX link; PinHeader_1x02_P2.54mm_Vertical; MPN TSW-102-07-G-S; not fitted
JP5: RX link; PinHeader_1x02_P2.54mm_Vertical; MPN TSW-102-07-G-S; not fitted
Q1: AO3400A; SOT-23; MPN AO3400A; LCSC C20917
Q2, Q3: Si2377EDS; SOT-23; MPN Si2377EDS-T1-GE3; LCSC C143698
Q4, Q5, Q6: 2N7002; SOT-23; MPN 2N7002,215; LCSC C65189
R1, R2, R3, R4, R5, R6, R9, R10, R17, R19, R21, R23, R24, R26, R28, R30, R34, R37: 10k; R_0805_2012Metric; MPN 0805W8F1002T5E; LCSC C17414
R7, R8, R13, R32, R35: 1k; R_0805_2012Metric; MPN 0805W8F1001T5E; LCSC C17513
R11, R12: 330; R_0805_2012Metric; MPN 0805W8F3300T5E; LCSC C17630
R14, R33: 100k; R_0805_2012Metric; MPN 0805W8F1003T5E; LCSC C149504
R15, R16: 15 1% 2W; R_2512_6332Metric; MPN RC2512FK-7W15RL; LCSC C6639259
R18, R22, R25, R29, R36, R38: 100; R_0805_2012Metric; MPN 0805W8F1000T5E; LCSC C17408
R20: 0.1 ohm Kelvin; R_Shunt_Vishay_WSK2512_6332Metric_T1.19mm; MPN WSK2512R1000FEA; not fitted
R27: 2.2; R_0805_2012Metric; MPN 0805W8F220KT5E; LCSC C17521
R31: 10k; R_0805_2012Metric; MPN 0805W8F1002T5E; LCSC C17414; not fitted
R39: 0; R_1206_3216Metric; MPN 1206W4F0000T5E; LCSC C17888
R40: 4.7k; R_0805_2012Metric; MPN RC0805FR-074K7L; not fitted
R41: 100k; R_0805_2012Metric; MPN RC0805FR-07100KL; not fitted
TP1: AUX_5V; TestPoint_Pad_D1.5mm; MPN PCB_PAD
TP2: MUX_VCC; TestPoint_Pad_D1.5mm; MPN PCB_PAD
TP3: VHIGH; TestPoint_Pad_D1.5mm; MPN PCB_PAD
TP4: VLOW; TestPoint_Pad_D1.5mm; MPN PCB_PAD
TP5: TARGET_VDD; TestPoint_Pad_D1.5mm; MPN PCB_PAD
TP6: GND; TestPoint_Pad_D1.5mm; MPN PCB_PAD
TP7: ISENSE_P; TestPoint_Pad_D1.5mm; MPN PCB_PAD
TP8: ISENSE_N; TestPoint_Pad_D1.5mm; MPN PCB_PAD
U1: Raspberry Pi Pico 2; RaspberryPi_Pico_Common_THT; MPN SC1631
U2: UCC27517DBVR; SOT-23-5; MPN UCC27517DBVR; LCSC C99395
U3: NX3L1T3157GMZ; SOT-886; MPN NX3L1T3157GMZ; LCSC C1870392
U4: AP2112K-3.3; SOT-23-5; MPN AP2112K-3.3TRG1; LCSC C51118
U5: AP2112K-1.8; SOT-23-5; MPN AP2112K-1.8TRG1; LCSC C176944
U6: TPS7A2036PDBVR; SOT-23-5; MPN TPS7A2036PDBVR; LCSC C2873626
U7: SN74LVC1G17; SOT-23-5; MPN SN74LVC1G17DBVR; LCSC C7836
U8: SN74AXC4T774PWR; TSSOP-16_4.4x5mm_P0.65mm; MPN SN74AXC4T774PWR; not fitted

Connections:
/3V3: C16.1, C17.1, R6.2, R34.2, U1.36 (3V3), U7.5 (VCC), U8.1 (DIR1), U8.16 (VCCA)
/AG: Q6.1 (G), R25.2, R26.1
/AL: JP2.1, Q6.3 (D)
/ARM_EN: R5.1, R25.1, U1.11 (GP8)
/AUX5: C1.1, C2.1, C3.1, C6.1, C13.1, C14.1, D1.2 (A), F1.2, R24.1, TP1.1, U2.1 (VDD), U4.1 (VIN), U5.1 (VIN)
/CB_PULSE: R1.1, R22.1, U1.4 (GP2)
/EN_H: R8.2, R9.1, U4.3 (EN)
/EN_L: R10.1, R35.2, U5.3 (EN)
/GL: J1.1, Q1.3 (D)
/GND: C1.2, C2.2, C3.2, C4.2, C5.2, C6.2, C7.2, C8.2, C9.2, C10.2, C11.2, C12.2, C13.2, C14.2, C16.2, C17.2, C18.2, D2.1 (K), J1.2, J2.2, J3.2, J4.2, J5.1, Q1.2 (S), Q4.2 (S), Q5.2 (S), Q6.2 (S), R1.2, R2.2, R3.2, R4.2, R5.2, R9.2, R10.2, R11.2, R12.2, R14.2, R19.2, R21.2, R23.2, R26.2, R28.2, R30.2, R33.2, R37.2, R40.2, R41.2, TP6.1, U1.3 (GND), U1.8 (GND), U1.13 (GND), U1.18 (GND), U1.23 (GND), U1.28 (GND), U1.33 (AGND), U1.38 (GND), U2.2 (GND), U3.2 (GND), U4.2 (GND), U5.2 (GND), U6.2 (GND), U7.3 (GND), U8.2 (DIR2), U8.7 (DIR3), U8.8 (DIR4), U8.10 (GND), U8.11 (B4), U8.12 (B3)
/HOLD: C9.1, C10.1, R13.2, U6.1 (IN), U6.3 (EN)
/ISENSE_N: R20.3 (SENSE-), TP8.1
/ISENSE_P: R20.2 (SENSE+), TP7.1
/LED: R7.1, U1.10 (GP7)
/LEDA: D2.2 (A), R7.2
/MUX_CMD: R3.1, R36.1, U1.7 (GP5)
/MUX_S: R36.2, R37.1, U3.6 (S)
/MVCC: C11.1, C12.1, R14.1, TP2.1, U3.5 (VCC), U6.5 (OUT)
/MY0: R15.2, U3.3 (Y0)
/MY1: R16.2, U3.1 (Y1)
/MZ: Q2.3 (D), U3.4 (Z)
/Q1G: Q1.1 (G), R27.2, R28.1
/Q4D: Q4.3 (D), R38.1
/Q23G: Q2.1 (G), Q3.1 (G), R17.2, R38.2
/Q23S: Q2.2 (S), Q3.2 (S), R17.1
/REN: R8.1, R35.1, U1.14 (GP10)
/RET: D1.1 (K), R13.1
/RST_ASSERT: R4.1, R29.1, U1.9 (GP6)
/RST_G: Q5.1 (G), R29.2, R30.1
/RST_T: J3.1, Q5.3 (D), R31.1
/TGT_G: Q4.1 (G), R18.2, R19.1
/TGT_ON: R2.1, R18.1, U1.6 (GP4)
/TRIG_F: R32.2, R33.1, U7.2 (A)
/TRIG_IN: J4.1, R32.1
/TRIG_OUT: U1.5 (GP3), U7.4 (Y)
/TVDD: J2.1, JP3.1, R20.4 (FORCE-), R21.1, R31.2, R39.2, TP5.1
/T_PRE: Q3.3 (D), R20.1 (FORCE+), R39.1
/U2N: JP2.2, R24.2, U2.4 (IN-)
/U2O: R27.1, U2.5 (OUT)
/U2P: R22.2, R23.1, U2.3 (IN+)
/UART_OE: R6.1, R34.1, U1.12 (GP9), U8.9 (OE)
/URX: U1.2 (GP1), U8.4 (A2)
/URX_C: J5.2, JP4.2
/URX_T: JP4.1, U8.14 (B1)
/UTX: U1.1 (GP0), U8.3 (A1)
/UTX_C: J5.3, JP5.2
/UTX_T: JP5.1, R41.1, U8.13 (B2)
/UVCCB: C18.1, JP3.2, R40.1, U8.15 (VCCB)
/VBUS: F1.1, U1.40 (VBUS)
/VH: C4.1, C5.1, R11.1, R15.1, TP3.1, U4.5 (VOUT)
/VL: C7.1, C8.1, R12.1, R16.1, TP4.1, U5.5 (VOUT)

Notes on the sheet:
1. Pico 2 / boot defaults
2. Target reservoirs (upstream of current limits)
3. Voltage selector / slow disconnect
4. Retained 3.6 V mux supply
5. Reset / 3.3 V trigger
6. USB auxiliary branch / separate crowbar
7. Optional UART (native DNP)
8. Probe pads / ERC flags
C4 ENGINEERING PROTOTYPE - HARDWARE UNQUALIFIED
15 ohm in each mux input; <=10 mA total target load.
100 nF: about 5.8 us settling; no settled 100 ns plateau.
GL is separate from TVDD. External supply: unplug TVDD.
No stuck-on timeout. Supervised expendable targets only.
U8/JP3-JP5/C18/R20/R31/R40/R41: DNP. ARM ships OPEN.
VH/VL=3.3/1.8 V reservoirs; MVCC=mux VCC; TVDD=target.
RST_ASSERT=1 asserts reset. Full alias list: hardware/README.md.

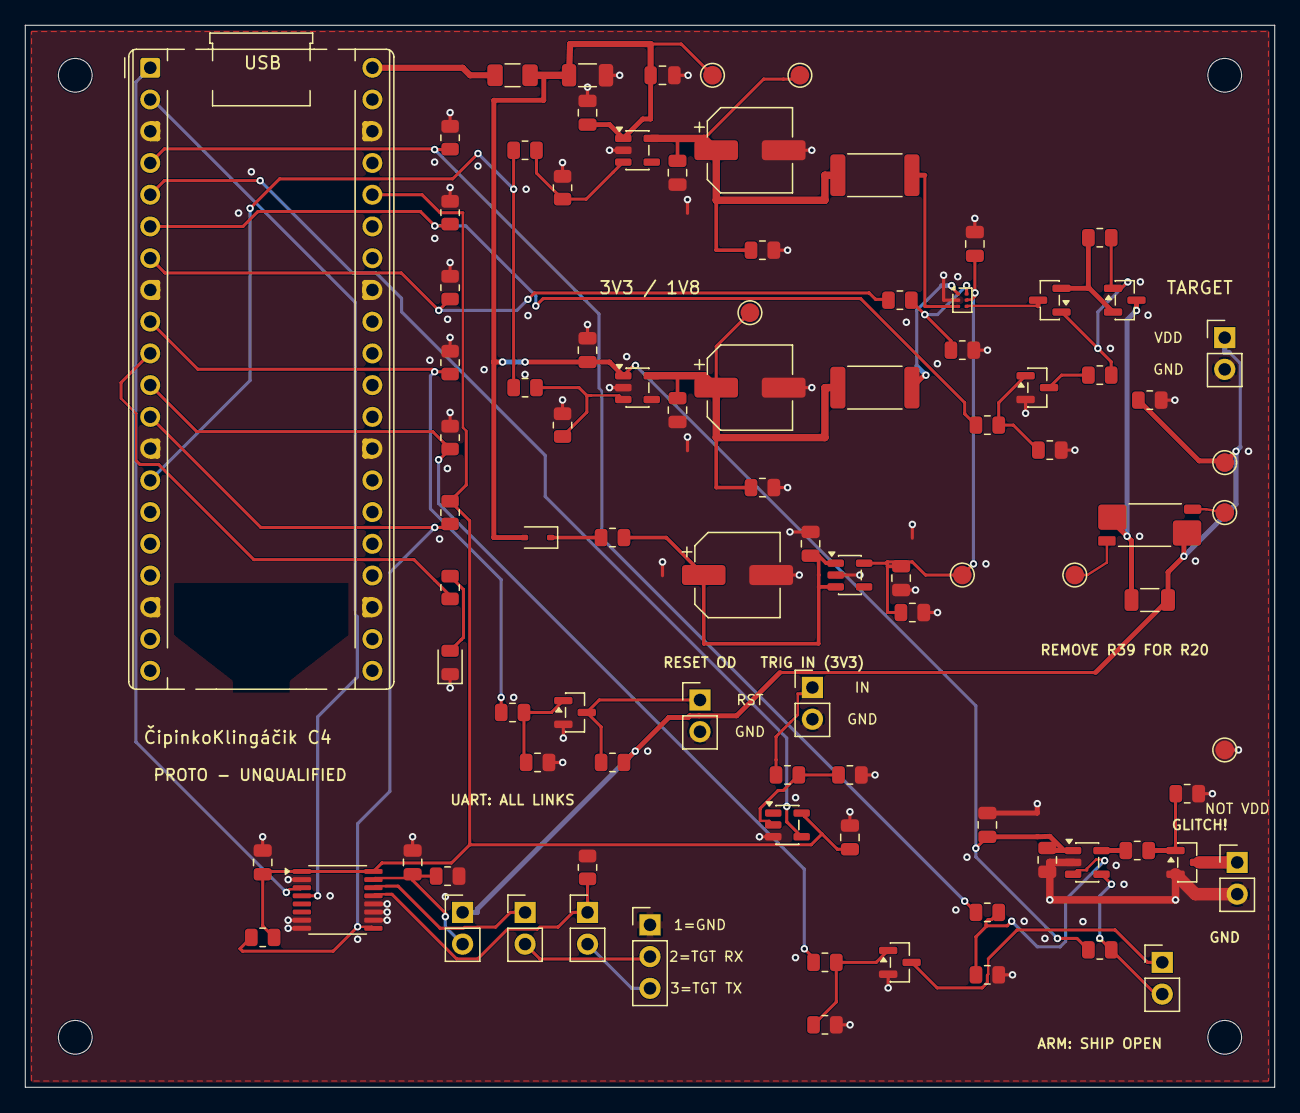
[picture p17: board cipinkoklingacik.kicad_pcb from above]

Board: 2 copper layers, 100.0 x 85.0 mm, 96 parts (0 on the bottom side), 51 nets.

Other parts of the board:
H1, H2, H3, H4: M2.5 NPTH; MountingHole_2.7mm_M2.5
