uncovert/CipinkoKlingacik/(commit log)

2026-10-30 Prepare ČipinkoKlingáčik C3 engineering-prototype alpha
    [accessories-candidates.csv, baseline-hand-fit.csv, baseline-smt-bom.csv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]
2026-10-30 Prepare C4 alpha.2 with stocked sourcing and DFM audit fixes
    [baseline-hand-fit.csv, baseline-smt-bom.csv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]
